paulforrester/diy-ha-sensor/README.md

# diy-ha-sensor

A DIY, USB-C powered room sensor for Home Assistant, running ESPHome. It reports:

- **presence**, including a person sitting still;
- **illuminance**, with 0.1 lx resolution near darkness;
- **temperature and humidity**, kept away from the electronics' own heat;
- **diagnostics**: Wi-Fi signal, uptime, chip temperature and sensor faults.

It is meant to be cheaper than buying several commercial sensors, and to fix what the current ones get wrong. The Apollo
MSR-2 reads several degrees high and has no humidity. The Aqara FP300 reports slowly and misses people sitting still.

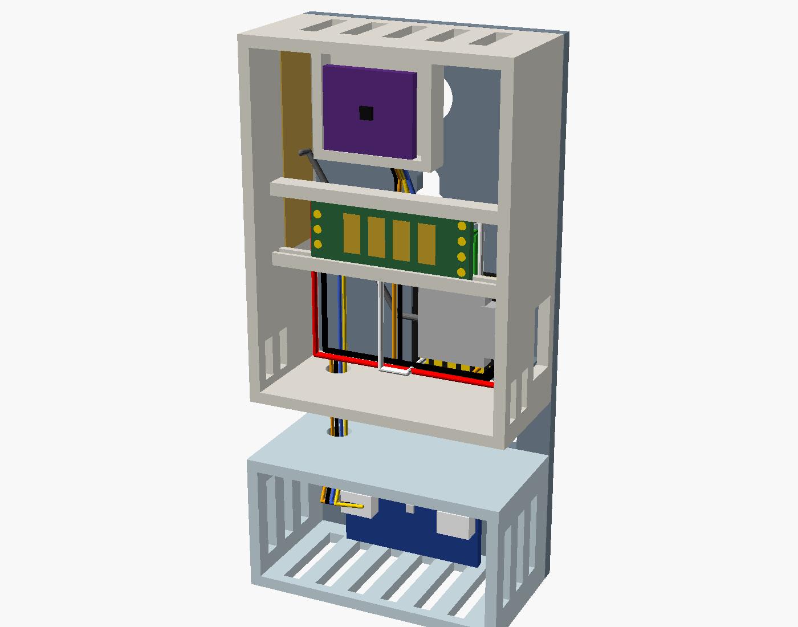
[picture p1: docs/images/concept/concept_cutaway.png]
Concept: front walls removed, showing the radar, light cell, XIAO and the separate climate pod


*Phase 0 concept render: a picture of the proposal, not a printable design (see `cad/concept/README.md`).*

## Status

**Phase 2: firmware.** The design is approved (option B) and the parts list for a run of 10 is merged. The ESPHome
firmware and CI are in review. Nothing is built yet.

- [`docs/design_proposal.md`](docs/design_proposal.md): the approved design, its reasoning and risks.
- [`docs/bom.md`](docs/bom.md): parts, quantities, sources and costs (prices live-checked 2026-10-15).
- [`firmware/README.md`](firmware/README.md): the ESPHome packages, pin map, entities and how to flash.
- [`docs/design_decisions.md`](docs/design_decisions.md): the decision log.
- Concept renders, STLs you can rotate on GitHub, and the wiring diagram are in proposal section 6.0 and
  `cad/concept/`. The real enclosure comes in Phase 3.

| Phase | Content | State |
|---|---|---|
| 0 | Questions and design proposal | Done (PR #1) |
| 1 | Bill of materials and sourcing | Done (PR #2); live prices in PR #4 |
| 2 | ESPHome firmware and CI | In review |
| 3 | OpenSCAD enclosure, fit-test coupons first | Not started |
| 4 | Build, calibration, validation and HA docs | Not started |
| 5 | Bring-up and revision from bench results | Not started |

## Repository layout

| Path | Contents |
|---|---|
| `docs/` | Design proposal and images, decision log, BOM; later the build guide, wiring, calibration, validation and HA integration |
| `tools/` | Helper scripts (BOM tables from `docs/bom.csv`) |
| `CLAUDE.md` | Context and working rules for Claude sessions on this repo |
| `firmware/` | ESPHome packages, variants and device files |
| `.github/workflows/` | CI: ESPHome config and compile, BOM table check |
| `cad/concept/` | Phase 0 concept model: OpenSCAD source, render and interference-check scripts, STLs |
| `cad/` | (Phase 3) OpenSCAD sources, STLs and renders for the real enclosure |

Secrets never go in the repo: `secrets.yaml` is git-ignored, and a `secrets.example.yaml` will show the keys needed.
