paulforrester/diy-ha-sensor/docs/bom.md

# Bill of materials and sourcing (Phase 1)

- **Date:** 2026-10-15 (`TZ=Europe/Paris date`).
- **Status:** draft for Paul's review. **Nothing is ordered**; Paul buys everything.
- **Prices:** **live-checked on 2026-10-15** for lines 1-14, from the shop pages themselves (a session on Paul's Mac,
  not behind the cloud proxy). Prices include VAT; stock, shipping and delivery estimates are in `docs/bom.csv`.
  Line 15 (PETG) is Paul's stock and isn't priced. Shop prices and stock change daily, and the cart is the only exact
  figure for delivery, VAT and duty (section 8, step 7).
- **Source of truth:** `docs/bom.csv`. The parts table and the cost tables below are generated from it by
  `python3 tools/bom_totals.py`. Edit the CSV, then re-run the script; don't edit those tables by hand.

## 1. Summary

**The run:** 10 identical standard units, plus spares. Each unit has:

- the option B design approved on PR #1:
  - XIAO ESP32-C3;
  - LD2412 radar;
  - genuine SHT45;
  - OPT3001 lux sensor;
  - the two-part case with the separate climate pod;
- a CO2 sensor as standard, so every unit is interchangeable (Paul's decision);
- a 1-Wire socket for optional remote temperature probes (DS18B20), so probes can be added later without changing
  the unit (Paul's decision; section 5);
- its own USB wall adapter and a white 2 m USB-A to USB-C cable.

**Cost** (live prices, 2026-10-15; section 4 has the detail):

| | Cost |
|---|---|
| Standard unit, per unit | about €76-86 |
| ...of which the CO2 sensor (genuine Adafruit SCD-40) | about €47-53 |
| USB adapter and cable, per unit | about €14-16.50 |
| **Whole run**, before delivery and duty | **about €1,020-1,200** |

Against the snippet estimate (€868-1,125), the low end rose by about €150 and the high end by about €70 [calc]:

- **USB adapters, about +€75:** the €2.50 adapter in the draft is an unbranded 1 A part that fails this BOM's own
  "reputable brand" rule. Branded ones on Amazon.fr cost €10-12 each (line 11). Paul decides; see section 3.
- **OPT3001 boards, about +€28, and radars, about +€21:** real listings cost more than the snippets suggested.
- **Everything from DigiKey** is within a few cents of the snippet figures.

**Why the CO2 sensor costs more than the brief's estimate.** The brief estimated €20-25 per CO2 sensor.

- That price only exists for unbranded marketplace SCD40 boards, which carry a real counterfeit and refurbished risk.
- Apollo's €23.99 SCD40 module doesn't fit this design. It plugs into a proprietary mezzanine connector on Apollo's
  board (Apollo docs, "Adding CO2 to MSR-2").

If the cost matters, the one large saving left is unbranded SCD40 boards, at about €10-25 each [S]. They would be
checked on arrival using the variant and serial commands and an outdoor reading near 420 ppm. I don't recommend it for
a run whose point is accurate, interchangeable units.

## 2. What changed since the proposal

- **Quantities:** a run of 10, not 4. Some units may go to the US; only the USB wall adapter differs (section 6).
- **CO2 is standard on every unit** (Paul, 2026-10-15).
  - The proposal's cheapest genuine option, the Apollo module, is out (connector, above), so the Adafruit SCD-40 is
    the primary.
  - Adafruit's board has a 3.3 V regulator and level shifters, and runs from 3.3 to 5 V (Adafruit-SCD-4x-PCB README
    on GitHub).
  - It is wired to the XIAO's 3V3 by default. The I2C pull-ups follow the board's supply, so feeding it 5 V could put
    5 V on the ESP32's I2C pins.
  - Phase 2 checks Adafruit's schematic, and checks the XIAO's 3.3 V regulator headroom. The XIAO wiki states both
    500 mA and 700 mA [G]. The ESP32-C3 Wi-Fi peak (350 mA) plus the SCD40 peak (175 mA) is about 525 mA [D] [A].
- **No separate cellar design.** The cellar gets a standard unit like every other room.
- **1-Wire socket on every unit** (Paul, 2026-10-15). It costs well under €1 per unit [A], and it keeps the units
  interchangeable while leaving room for remote temperature probes later (section 5).
- **USB supply and cable:** one each per unit (Paul's answer). A USB-A supply with an A-to-C cable avoids USB-C power
  negotiation questions entirely.

## 3. Parts, quantities and sources

The run quantity is the per-unit quantity × 10, plus spares.

<!-- parts:start (generated by tools/bom_totals.py) -->

| # | Part | Per unit | Run qty | Primary source | Alternative | Price each | Price basis | Counterfeit risk |
|---|---|---|---|---|---|---|---|---|
| 1 | **Seeed XIAO ESP32-C3**<br>Seeed SKU 113991054; includes the U.FL FPC antenna | 1 | 12 | [DigiKey.fr](https://www.digikey.fr/en/products/detail/seeed-technology-co-ltd/113991054/16652880) | [Gotronic](https://www.gotronic.fr/art-carte-xiao-esp32c3-35643.htm) | €5.53 - €5.90 | live-checked 2026-10-15 | low (Seeed via distributor) |
| 2 | **HLK-LD2412 radar**<br>Hi-Link LD2412, ±75° version; check firmware is not V1.26 on arrival | 1 | 12 | [AliExpress, Shenzhen Hi-Link module Store (store 4418003)](https://fr.aliexpress.com/item/1005007588627535.html) | [Domadoo (Apollo-sold module)](https://www.domadoo.fr/en/smart-home-products/8382-apollo-automation-mmwave-ld2412-sensor.html) | €4.49 - €5.99 | live-checked 2026-10-15 | low to medium (Hi-Link-named stores; which one is Hi-Link's own is not confirmed) |
| 3 | **HLK-LD2410C radar (fallback and comparison)**<br>Hi-Link LD2410C; same family as the Apollo's LD2410B | 0 | 2 | [AliExpress, Shenzhen Hi-Link Power& Radar& Router Module Store (store 1103670545)](https://fr.aliexpress.com/item/1005007273671377.html) | [Amazon.fr (RUANI 5-pack)](https://www.amazon.fr/RUANI-HLK-LD2410C-Pr%C3%A9sence-D%C3%A9tection-Mouvement/dp/B0DCJLRLKJ) | €3.59 - €5.72 | live-checked 2026-10-15 | low to medium |
| 4 | **Adafruit SHT45 breakout**<br>Adafruit product 5665 (Sensirion SHT45-AD1B, STEMMA QT) | 1 | 11 | [DigiKey.fr](https://www.digikey.fr/en/products/detail/adafruit-industries-llc/5665/17831054) | [Berrybase](https://www.berrybase.de/en/adafruit-sensirion-sht45-precision-temperature-humidity-sensor) | €13.18 - €14.90 | live-checked 2026-10-15 | low (Adafruit via distributor) |
| 5 | **OPT3001 breakout (CJMCU-3001)**<br>Generic CJMCU-3001 board: 6 pins VCC, GND, SCL, SDA, INT, ADD; no LED | 1 | 13 | [AliExpress, SZ Discount Store (CJMCU-3001)](https://fr.aliexpress.com/item/1005007837370286.html) | [AliExpress, A+A+A Store (same CJMCU-3001 layout)](https://fr.aliexpress.com/item/1005006398173401.html) | €3.19 - €3.69 | live-checked 2026-10-15 | medium (generic board; check the TI marking) |
| 6 | **JST-SH 4-pin cable for the SHT45**<br>STEMMA QT / Qwiic JST-SH plug at one end, female sockets (4397) or male pins (4209) at the other; 150 mm | 1 | 12 | [DigiKey.fr, Adafruit 4397 (female sockets)](https://www.digikey.fr/en/products/detail/adafruit-industries-llc/4397/10824270) | [DigiKey.fr, Adafruit 4209 (male header pins)](https://www.digikey.fr/en/products/detail/adafruit-industries-llc/4209/10230003) | €1.00 | live-checked 2026-10-15 | low |
| 7 | **Adafruit SCD-40 CO2 breakout**<br>Adafruit product 5187 (Sensirion SCD40, STEMMA QT, onboard 3.3 V regulator and level shifters) | 1 | 11 | [DigiKey.fr](https://www.digikey.fr/en/products/detail/adafruit-industries-llc/5187/15194668) | [Berrybase (Adafruit SCD-41, product 5190)](https://www.berrybase.de/en/adafruit-scd-41-co2-sensor-400-5000-ppm-40ppm-5-temperature-and-humidity-sensor-3.3-5v) | €47.36 - €52.90 | live-checked 2026-10-15 | low (Adafruit via distributor); high for unbranded marketplace SCD4x |
| 8 | **JST-SH 4-pin cable for the SCD-40**<br>as line 6, 150 mm | 1 | 11 | [DigiKey.fr, Adafruit 4397 (as line 6)](https://www.digikey.fr/en/products/detail/adafruit-industries-llc/4397/10824270) | [DigiKey.fr, Adafruit 4209 (as line 6)](https://www.digikey.fr/en/products/detail/adafruit-industries-llc/4209/10230003) | €1.00 | live-checked 2026-10-15 | low |
| 9 | **4.7 kΩ resistor, 1-Wire pull-up**<br>1/4 W through-hole; pulls the 1-Wire line (D2 / GPIO4) up to 3V3 | 1 | 15 | [DigiKey.fr, Stackpole CF14JT4K70](https://www.digikey.fr/en/products/detail/stackpole-electronics-inc/CF14JT4K70/1741428) | [AliExpress resistor assortment](https://www.aliexpress.com/w/wholesale-resistor-kit-1-4w.html) | €0.03 | live-checked 2026-10-15 | low |
| 10 | **JST-XH 3-pin header, 1-Wire socket**<br>JST XH series, 3 positions, 2.50 mm pitch, vertical through-hole header; mates with an XH 3-pin housing on a future probe cable | 1 | 12 | [DigiKey.fr, JST B3B-XH-A (455-2248-ND)](https://www.digikey.fr/en/products/detail/jst-sales-america-inc/B3B-XH-A/1651046) | [AliExpress, 230-piece 'XH2.54' 2-5 pin kit](https://fr.aliexpress.com/item/1005009454589816.html) | €0.12 | live-checked 2026-10-15 | low (genuine JST via distributor) |
| 11 | **USB wall adapter, 5 V**<br>USB-A output, 5 V at least 1 A (2 A preferred), EU plug, CE marked, reputable brand | 1 | 10 | [Amazon.fr, Belkin WCB002VFWH (2 × USB-A, 12 W per port)](https://www.amazon.fr/dp/B086H34XZW) | [Amazon.fr, Hama 2 × USB-A 12 W (black)](https://www.amazon.fr/dp/B0F8KHS5H9) | €9.99 - €11.99 | live-checked 2026-10-15 | medium (electrical safety: avoid unbranded adapters) |
| 12 | **USB-A to USB-C cable**<br>White, 2 m, USB-A to USB-C (Paul, 2026-10-15) | 1 | 10 | [Amazon.fr, PremiumCord USB-A to USB-C, white, 2 m](https://www.amazon.fr/dp/B08LH76K5K) | [Amazon.fr, 2-pack white 2 m USB-A to USB-C (brand SRLWMYI)](https://www.amazon.fr/dp/B0GSZGJLCF) | €3.99 - €4.50 | live-checked 2026-10-15 | low |
| 13 | **Wiring consumables**<br>26 AWG silicone hookup wire (6 colours), heat-shrink assortment, 2 × 8 cm double-sided perfboard, 2.54 mm male and female header strips | — | 1 | [AliExpress (four listings, see notes)](https://fr.aliexpress.com/item/1005010394567962.html) | Amazon.fr (not checked) | €10.46 - €26.97 | live-checked 2026-10-15 | low |
| 14 | **Fixings**<br>M2 self-tapping screws for board standoffs (assortment); wall screws and plugs (2 per unit) not priced | — | 1 | [Amazon.fr, VooGenzek 800-piece M2 self-tapping assortment](https://www.amazon.fr/dp/B09NDMWBC2) | local hardware shop | €9.99 | live-checked 2026-10-15 | low |
| 15 | **PETG filament**<br>About 60 g per unit plus fit coupons: about 0.7 kg; plus a little natural PETG only if the printed lux window is chosen | — | 1 | Paul's stock |  | €0.00 - €22.00 | assumed: Paul's stock, not priced | low |

<!-- parts:end -->

Notes per line are in `docs/bom.csv` (column `notes`); stock and delivery are in columns `stock` and `delivery`. The
ones that matter before ordering:

- **Line 1, XIAO:** buy single boards. DigiKey's 3-pack (102010572) works out at €4.74 per board but is listed
  without the U.FL antenna, which this board needs.
- **Line 2, LD2412:**
  - Pick the "HLK-LD2412 Module" variant; the listing opens on the LD2410B.
  - Three AliExpress stores carry the Hi-Link name, and Hi-Link's own site links none of them, so "Hi-Link's
    official store" is not confirmed.
  - The cheapest offer delivered is store 211069 at €4.49 each for 12, but it ships separately at €13.23. The primary
    (€4.89) ships free with the rest of order B.
  - Domadoo has only 6 in stock.
  - Check the firmware version in the ESPHome log on arrival: V1.26 has broken configuration commands
    (esphome #13366).
- **Line 4, SHT45:** the 18-week lead time in the snippet is gone: DigiKey has 1,345 in stock. Berrybase is out of
  stock.
- **Lines 4 and 7, LEDs on the Adafruit boards:** both have a green power LED (Adafruit's design files).
  - SHT45: the LED is hardwired. Desolder it.
  - SCD-40: cut solder jumper SJ3.

  Either way, no LED shows through the case vents at night.
- **Line 5, OPT3001:** a CJMCU-3001 board.
  - Both listings' photos show the ADD pin broken out and no LED.
  - ADD has a 10 kΩ resistor on the board whose direction (pull-up or pull-down) isn't visible. Measure it on arrival
    and strap ADD to VCC for 0x45 either way [A].
  - Board size isn't stated: measure it before the Phase 3 CAD.
  - The MikroElektronika Ambient 2 Click is dropped: DigiKey has none in stock, and it costs €17.92 incl. VAT.
- **Lines 6 and 8, STEMMA QT cables:** Adafruit 4397 (female sockets) or 4209 (male pins), both 150 mm and €1.00.
  Pick the end when the Phase 2 wiring is fixed.
- **Line 7, SCD-40:** DigiKey has 62 in stock, enough for 11.
- **Line 10, JST-XH header:** the part number is confirmed as **JST B3B-XH-A** (DigiKey 455-2248-ND). It moved to the
  DigiKey order (A): genuine JST, €0.12 each.
- **Line 11, USB adapter (Paul decides):** the draft's €2.50 adapter is unbranded ("Générique") and 1 A, which fails
  this line's own spec.
  - The primary is now Belkin WCB002VFWH at €11.99, sold by Amazon.
  - Hama's €9.99 adapter has only 3 in stock.
  - If Paul accepts unbranded adapters, the saving is about €75-95 for the run [calc].
- **Line 12, USB cable:** PremiumCord white 2 m at €3.99, shipped by a marketplace seller.

## 4. Cost

Prices are EUR per item including VAT. Ranges span the sources found and any assumption.

<!-- totals:start (generated by tools/bom_totals.py) -->

**Per unit** (one set of parts, no spares, no delivery):

| Build | Cost per unit | Price basis (lines) |
|---|---|---|
| Standard unit (option B with CO2) | €75.90 - €85.53 | 10 live |
| Standard unit + USB supply and cable | €89.88 - €102 | + 2 live |

**Whole run** (10 units plus spares and consumables):

| Group | Total | Price basis (lines) |
|---|---|---|
| Standard unit: option B with CO2 (MCU, radar, T/RH, lux, CO2, cables) | €860 - €973 | 10 live |
| USB supply and cable | €140 - €165 | 2 live |
| Consumables (one lot for the run) | €20.45 - €58.96 | 2 live, 1 assumed |
| **Total, before delivery and duty** | **€1,020 - €1,197** | |

**By order:**

| Order | Total |
|---|---|
| A: distributor (DigiKey.fr or Mouser.fr) | €757 - €841 |
| B: AliExpress | €113 - €158 |
| C: Amazon.fr | €150 - €175 |
| From Paul's stock | €0.00 - €22.00 |

<!-- totals:end -->

Not included above:

- **Delivery** (shop pages, 2026-10-15):
  - DigiKey.fr: free on EUR orders to France from €75, otherwise €25. Most packages arrive in 3 days. Order A is
    about €760, so it ships free.
  - AliExpress: the AliExpress-delivered listings chosen here ship free from €10, with delivery estimates of
    20-25 October. Seller-shipped listings charge per item (for example €13.23 for 12 radars from store 211069).
  - Amazon.fr: Standard delivery (3-5 working days) is free for Prime members; for others the fee is shown at
    checkout. The product pages only offered free delivery on a first order.
- **EU customs duty:** AliExpress pages say prices include VAT and duty is calculated at checkout. News reports say a
  flat €3 per goods category on parcels under €150 from outside the EU, since 2026-07-01, plus a handling fee from
  2026-11-01 whose amount isn't set [S, unverified]. With the primary listings, order B is about €118-134 [calc],
  under €150. Expect about €6-12 of duty.
- **VAT:** DigiKey lists prices ex-VAT and shows the with-VAT price on each product page; the figures here are the
  with-VAT ones. DigiKey's Incoterms page says UPS and FedEx shipments to France may be DDP (duties paid by DigiKey),
  while DHL is CPT (duty and VAT due on delivery). Pick UPS or FedEx and check the cart.
- **Berrybase** shows prices with German VAT (19 %). French VAT (20 %) may apply at checkout [A].

## 5. The 1-Wire socket and future probes

Every unit gets a socket for DS18B20 temperature probes on a cable. These are for readings away from the unit: wine or
bottle temperature in the cellar, floor versus ceiling, several racks. No probes are bought now.

- **On the unit:**
  - XIAO **D2 / GPIO4**, a free pin that is not a strapping pin (ESPHome's C3 strapping pins are GPIO2, 8 and 9);
  - a **4.7 kΩ pull-up to 3V3**;
  - a **JST-XH 3-pin header** inside the main body;
  - a cable knock-out in the case (Phase 3).
- **Firmware:** an optional ESPHome package (`one_wire` with the `gpio` platform, plus `dallas_temp`; both in
  2026.9.1), off by default (Phase 2).
- **Adding a probe later:**
  - Buy **genuine DS18B20+ chips from an authorised distributor** (DigiKey, Mouser, Farnell, RS) and build the probe:
    3-core cable, adhesive-lined heat shrink, optionally a stainless sleeve, and a pre-crimped XH 3-pin pigtail.
    Marketplace probes are not an option: a 2019 study bought DS18B20s from over 70 vendors, and every probe from eBay
    and AliExpress contained a counterfeit chip (github.com/cpetrich/counterfeit_DS18B20).
  - On first boot, check each probe's ROM code in the ESPHome log against the genuine pattern `28-xx-xx-xx-xx-00-00-xx`
    from the same study.
- **Open for bring-up:** how long a cable the 4.7 kΩ pull-up handles reliably is not established here. It is checked
  when the first probe is added [A].

## 6. Units that go to the US

- Use a US-plug 5 V USB-A adapter, bought in the US; everything else is the same.
- Those units need their own Wi-Fi credentials and DNS names; the firmware's substitutions handle that (Phase 2).

## 7. Shopping list by order

| Order | What | Qty | Why this shop |
|---|---|---|---|
| **A: DigiKey.fr** | XIAO ESP32-C3, single boards (line 1) | 12 | Genuine parts from authorised distributors, one shipment, free delivery from €75 (order is about €760) |
| | Adafruit SHT45 (4) | 11 | |
| | Adafruit SCD-40 (7) | 11 | |
| | Adafruit 4397 or 4209 STEMMA QT cables (6, 8) | 23 | |
| | Stackpole CF14JT4K70 4.7 kΩ resistors (9) | 15 | |
| | JST B3B-XH-A headers (10) | 12 | Moved from order B: genuine JST |
| **B: AliExpress** (one order) | LD2412, "HLK-LD2412 Module" variant (2) | 12 | Hi-Link-named store; AliExpress delivery, free from €10 |
| | LD2410C (3) | 2 | Hi-Link-named store |
| | CJMCU-3001 OPT3001 boards (5) | 13 | ADD pin, no LED in the photos |
| | Wiring consumables (13) | 1 lot | |
| **C: Amazon.fr** | USB wall adapters, EU plug (11) | 10 | Belkin, sold by Amazon (or Paul's choice, section 3) |
| | PremiumCord USB-A to C cables, white, 2 m (12) | 10 | |
| | M2 screw assortment (14) | 1 | |
| **Stock** | PETG filament (15) | about 0.7 kg | Colour still open |

Notes on the shopping list:

- **Order B:** one order keeps the €3 duty per goods category to a single parcel. The listings chosen are delivered
  by AliExpress and ship free from €10 (pages checked 2026-10-15). Seller-shipped listings charge shipping per item;
  check it in the cart.
- **EU fallback for the radars:** if the AliExpress lead time is a problem, Domadoo has the LD2412 at €5.99, but only
  6 in stock on 2026-10-15. OpenELAB and SmartHomeShop were not checked.

## 8. Live price pass

**Done on 2026-10-15** for lines 1-14 by a Claude Code session on Paul's Mac (branch `bom-live-prices`). Every shop
page opened:

- DigiKey.fr, Gotronic, Berrybase and Domadoo;
- AliExpress (fr.aliexpress.com, prices in EUR, shipping to France);
- Amazon.fr (delivering to Bordeaux, not signed in).

The draft's gaps are filled: the OPT3001 board, the JST-SH cables, the JST-XH part number, the white 2 m cables and
the SCD-40's DigiKey URL. Section 3 has the results. Stock and marketplace prices move, so repeat the pass with these
steps if the order is placed more than a few days later:

1. **Check out the branch.** Work on this PR's branch, and check that the PR isn't merged yet.
2. **Price each line.** For each line in `docs/bom.csv`, open the primary and alternative product pages. Record in
   that row:
   - the price including VAT, delivered to France;
   - the exact product URL;
   - stock;
   - shipping cost or free-delivery threshold;
   - delivery estimate.
3. **Label the prices.**
   - Set `price_status` to `live-checked YYYY-MM-DD`, and `date_checked` to the date.
   - Keep `eur_low` / `eur_high` as the cheapest and dearest credible offers.
   - If a page can't be read (JavaScript-only or bot-blocked pages are common on AliExpress, Amazon, DigiKey and
     Mouser), leave the line `estimated` and say so in `notes`. Never record a guess as live.
4. **Check the choices still hold.** On AliExpress, select the right variant before reading the price (the listings
   open on a different model). Raise the quantity to the run quantity to see seller shipping, which scales with
   quantity.
5. **Regenerate.** Re-run `python3 tools/bom_totals.py` and check that the tables in sections 3 and 4 changed as
   expected.
6. **Commit.** Commit with a message that lists which lines were live-checked, and push to the same branch.
7. **Final check by Paul.** The cart is the only exact figure for delivery, VAT and duty, so Paul checks it before
   paying.

## 9. Open questions

The BOM itself has no open questions left. These are still open from the proposal (section 10 there), and none of
them blocks ordering:

- rooms and mounting positions;
- filament colour;
- Bluetooth proxy;
- the device naming pattern (`sense-<room>` suggested);
- whether `mulet.flypig.net` may appear in the public repo;
- the Arty Player and Apollo settings.

## 10. Sources

- **Prices, URLs, stock and shipping:** the shop pages themselves, read on 2026-10-15 (section 8). Shipping rules:
  DigiKey.fr "Delivery Time and Cost" and "Incoterms" help pages; Gotronic product page (Livraison tab); Berrybase
  "Payment / Dispatch"; Domadoo "Delivery"; Amazon.fr "Delivery Costs and Times in Mainland France and Monaco". The
  notes behind each figure are in the `notes` column of `docs/bom.csv`.
- **Apollo SCD40 module connector:** Apollo docs, `docs/products/msr2/addons/adding-co2-to-msr-2.md` in
  https://github.com/ApolloAutomation/docs.
- **Adafruit SCD-4x board** (regulator and level shifters): https://github.com/adafruit/Adafruit-SCD-4x-PCB README.
- **Adafruit SHT4x boards:** https://github.com/adafruit/Adafruit-SHT40-PCB README (products 4885, 5776, 5665).
- **DS18B20 counterfeits and the ROM-pattern check:** https://github.com/cpetrich/counterfeit_DS18B20 README.
- **ESPHome 2026.9.1:** `one_wire`, `gpio` 1-Wire platform, `dallas_temp`, and the ESP32-C3 strapping pins
  (`esp32/gpio_esp32_c3.py`), checked in the installed source.
- **XIAO ESP32-C3 regulator rating** (500 mA and 700 mA both stated): Seeed wiki source on GitHub, as cited in
  `docs/design_proposal.md` section 11.
