paulforrester/diy-ha-sensor/docs/bom.csv

id | group | part | spec | qty_per_unit | units | spares | qty_total | primary_source | primary_url | primary_eur | alt_source | alt_url | alt_eur | eur_low | eur_high | price_status | date_checked | shipping_to_fr | delivery | stock | counterfeit_risk | order | notes
1 | core | Seeed XIAO ESP32-C3 | Seeed SKU 113991054; includes the U.FL FPC antenna | 1 | 10 | 2 | 12 | DigiKey.fr | https://www.digikey.fr/en/products/detail/seeed-technology-co-ltd/113991054/16652880 | 5.53 | Gotronic | https://www.gotronic.fr/art-carte-xiao-esp32c3-35643.htm | 5.90 | 5.53 | 5.90 | live-checked 2026-10-15 | 2026-10-15 | DigiKey.fr: free from €75 (EUR orders to France), else €25. Gotronic: Lettre suivie €2.90 (free from €30), relay from €4.50 (free from €120), Colissimo €5.90 (free from €180) | DigiKey: most packages to France in 3 days (DigiKey delivery page); standard lead time 4 weeks. Gotronic: 48 h by relay or Colissimo, about 4 days by Lettre suivie | DigiKey 9,349; Gotronic 210 | low (Seeed via distributor) | A | DigiKey €4.61 ex-VAT, €5.53 with VAT; includes the U.FL antenna (DigiKey attribute). The 3-pack 102010572 (€14.21 incl. VAT, €4.74 per board) is listed as 'U.FL Antenna(s) Not Included', so it is not cheaper once antennas are added. Gotronic €5.90 TTC (€4.92 HT, includes €0.05 eco-part).
2 | core | HLK-LD2412 radar | Hi-Link LD2412, ±75° version; check firmware is not V1.26 on arrival | 1 | 10 | 2 | 12 | AliExpress, Shenzhen Hi-Link module Store (store 4418003) | https://fr.aliexpress.com/item/1005007588627535.html | 4.89 | Domadoo (Apollo-sold module) | https://www.domadoo.fr/en/smart-home-products/8382-apollo-automation-mmwave-ld2412-sensor.html | 5.99 | 4.49 | 5.99 | live-checked 2026-10-15 | 2026-10-15 | AliExpress-delivered listing: free from €10 (Colissimo, Colis Privé, Mondial Relay). Domadoo: Mondial Relay €3.90 below €139, free from €139; DPD Pickup €4.90 below €149 | AliExpress primary: 20-24 Oct. Domadoo: same-day dispatch if paid before 10:00 | AliExpress primary 45; Domadoo 6 (fewer than the 12 needed) | low to medium (Hi-Link-named stores; which one is Hi-Link's own is not confirmed) | B | Pick the 'HLK-LD2412 Module' variant (€4.89; the listing's default is LD2410B). Prices include VAT; AliExpress says duty is calculated at checkout. Low end: 'Shenzhen Hi-Link IoT Module Store' (store 211069), https://fr.aliexpress.com/item/1005006990598837.html, €3.39 each + €13.23 seller shipping for 12 = €4.49 each delivered, 97 in stock, 23-29 Oct. Three AliExpress stores use the Hi-Link name (4418003, 211069, 1103670545); hlktech.net's home page links none of them, so which one is Hi-Link's own is not confirmed. Store 1103670545: LD2412 €5.09 (21 in stock) on item 1005007989577185, and 'cannot be delivered to this address' on item 1005007273671377. The primary listing's photo says a new version with a revised antenna layout keeps the same size and pinout (seller's claim). Domadoo's page text says '60 GHz'; the LD2412 is a 24 GHz radar, so treat that page's specs with care.
3 | core | HLK-LD2410C radar (fallback and comparison) | Hi-Link LD2410C; same family as the Apollo's LD2410B | 0 | 10 | 2 | 2 | AliExpress, Shenzhen Hi-Link Power& Radar& Router Module Store (store 1103670545) | https://fr.aliexpress.com/item/1005007273671377.html | 3.59 | Amazon.fr (RUANI 5-pack) | https://www.amazon.fr/RUANI-HLK-LD2410C-Pr%C3%A9sence-D%C3%A9tection-Mouvement/dp/B0DCJLRLKJ | 5.72 | 3.59 | 5.72 | live-checked 2026-10-15 | 2026-10-15 | AliExpress-delivered listing: free from €10. Amazon.fr: seller-dependent; the page offered free delivery on a first order only | AliExpress: 22-25 Oct. Amazon.fr: 17-18 Oct | AliExpress: not shown; Amazon.fr: in stock | low to medium | B | Two only: a side-by-side comparison on the first unit, and a fallback if an LD2412 has bad firmware. Pick the 'HLK-LD2410C' variant. Amazon.fr is a 5-pack at €28.59 (€5.72 each, sold by faxinhuif), so it means buying 5 for 2. Also seen: store 4418003 item 1005002765790429 at €3.29 + €3.40 seller shipping for one.
4 | core | Adafruit SHT45 breakout | Adafruit product 5665 (Sensirion SHT45-AD1B, STEMMA QT) | 1 | 10 | 1 | 11 | DigiKey.fr | https://www.digikey.fr/en/products/detail/adafruit-industries-llc/5665/17831054 | 13.18 | Berrybase | https://www.berrybase.de/en/adafruit-sensirion-sht45-precision-temperature-humidity-sensor | 14.90 | 13.18 | 14.90 | live-checked 2026-10-15 | 2026-10-15 | DigiKey.fr: free from €75 (EUR orders to France), else €25. Berrybase to EU countries: DHL €9.90, free from €250 | DigiKey: most packages to France in 3 days (DigiKey delivery page); standard lead time 4 weeks. Berrybase: not stated for France | DigiKey 1,345; Berrybase out of stock ('Currently not available') | low (Adafruit via distributor) | A | DigiKey €10.98 ex-VAT, €13.18 with VAT. The earlier 18-week lead-time snippet is out of date. Berrybase €14.90 is shown with German VAT (19 %); French VAT may apply at checkout [A]. Botland not checked. Check the laser marking, address 0x44 and the serial number on arrival (proposal 4.4). Board facts from Adafruit's design files (Adafruit-SHT40-PCB, SHT45 .brd/.sch): 25.4 x 17.78 mm, four 2.5 mm plated holes at 2.54 mm from the edges, AP2127K-3.3 regulator. Its green power LED (D1) is hardwired with no jumper: desolder it before assembly so no light leaks from the climate pod.
5 | core | OPT3001 breakout (CJMCU-3001) | Generic CJMCU-3001 board: 6 pins VCC, GND, SCL, SDA, INT, ADD; no LED | 1 | 10 | 3 | 13 | AliExpress, SZ Discount Store (CJMCU-3001) | https://fr.aliexpress.com/item/1005007837370286.html | 3.19 | AliExpress, A+A+A Store (same CJMCU-3001 layout) | https://fr.aliexpress.com/item/1005006398173401.html | 3.69 | 3.19 | 3.69 | live-checked 2026-10-15 | 2026-10-15 | AliExpress-delivered listing: free from €10 (both listings) | Primary: 22-25 Oct. Alternative: 20-24 Oct | Primary 984; alternative not shown | medium (generic board; check the TI marking) | B | Photos on both listings show the ADD pin broken out, the OPT3001, a 3-pin SOT-23 part, four resistors, two capacitors and no LED. ADD has a resistor on the board ('103', 10 kΩ, in the A+A+A photo); whether it pulls up or down is not visible, so measure it on arrival and strap ADD to VCC for 0x45 either way [A]. Board size is not stated on either listing: measure on arrival before the Phase 3 CAD. Rejected: SZFYDOSH green board (item 1005009295513152, €2.16) has no ADDR pin (solder pads 44/45/46/47 instead) and only 13 in stock; MikroElektronika Ambient 2 Click (MIKROE-1903) on DigiKey is €14.93 ex-VAT and out of stock (MIKROE-5544: 1 in stock).
6 | core | JST-SH 4-pin cable for the SHT45 | STEMMA QT / Qwiic JST-SH plug at one end, female sockets (4397) or male pins (4209) at the other; 150 mm | 1 | 10 | 2 | 12 | DigiKey.fr, Adafruit 4397 (female sockets) | https://www.digikey.fr/en/products/detail/adafruit-industries-llc/4397/10824270 | 1.00 | DigiKey.fr, Adafruit 4209 (male header pins) | https://www.digikey.fr/en/products/detail/adafruit-industries-llc/4209/10230003 | 1.00 | 1.00 | 1.00 | live-checked 2026-10-15 | 2026-10-15 | with order A | DigiKey: most packages to France in 3 days (DigiKey delivery page) | 4397: 4,325; 4209: 5,948 | low | A | Both €0.83 ex-VAT, €1.00 with VAT, 150 mm. Pick the end (female or male pins) when the Phase 2 wiring is fixed. Crosses the air gap between the body and the climate pod. AliExpress: two searches found only double-ended SH cables or loose crimped leads, no single-ended 4-pin pigtail, so no AliExpress price.
7 | core | Adafruit SCD-40 CO2 breakout | Adafruit product 5187 (Sensirion SCD40, STEMMA QT, onboard 3.3 V regulator and level shifters) | 1 | 10 | 1 | 11 | DigiKey.fr | https://www.digikey.fr/en/products/detail/adafruit-industries-llc/5187/15194668 | 47.36 | Berrybase (Adafruit SCD-41, product 5190) | https://www.berrybase.de/en/adafruit-scd-41-co2-sensor-400-5000-ppm-40ppm-5-temperature-and-humidity-sensor-3.3-5v | 52.90 | 47.36 | 52.90 | live-checked 2026-10-15 | 2026-10-15 | DigiKey.fr: free from €75 (EUR orders to France), else €25. Berrybase to EU countries: DHL €9.90, free from €250 | DigiKey: most packages to France in 3 days (DigiKey delivery page); standard lead time 4 weeks. Berrybase: '1-3 days' on the page | DigiKey 62; Berrybase 23 | low (Adafruit via distributor); high for unbranded marketplace SCD4x | A | DigiKey €39.47 ex-VAT, €47.36 with VAT. Berrybase SCD-41 €52.90 is shown with German VAT (19 %); French VAT may apply at checkout [A]. DigiKey also lists the Adafruit SCD-41 (5190) at €43.86 ex-VAT (seen in a related-products panel, not opened). Apollo's €23.99 SCD40 module is not usable here: it plugs into a proprietary mezzanine connector (Apollo docs). Other genuine options not checked: SparkFun SCD40 Qwiic (22395), Seeed Grove SCD41, DFRobot SCD41. Board facts from Adafruit's design files (Adafruit-SCD-4x-PCB, SCD-41 .brd/.sch, assumed the same PCB as the SCD-40 [A]): 25.4 x 22.86 mm, four 3.0 mm plated holes, AP2112K-3.3 regulator. Cut solder jumper SJ3 to turn off its green power LED. Powered from the XIAO 3V3, its I2C pull-ups sit at 3.3 V whatever SJ1 is set to.
8 | core | JST-SH 4-pin cable for the SCD-40 | as line 6, 150 mm | 1 | 10 | 1 | 11 | DigiKey.fr, Adafruit 4397 (as line 6) | https://www.digikey.fr/en/products/detail/adafruit-industries-llc/4397/10824270 | 1.00 | DigiKey.fr, Adafruit 4209 (as line 6) | https://www.digikey.fr/en/products/detail/adafruit-industries-llc/4209/10230003 | 1.00 | 1.00 | 1.00 | live-checked 2026-10-15 | 2026-10-15 | with order A | DigiKey: most packages to France in 3 days (DigiKey delivery page) | as line 6 | low | A | Adafruit's pigtails are 150 mm, not the 100 mm first planned; the spare length folds inside the body.
9 | core | 4.7 kΩ resistor, 1-Wire pull-up | 1/4 W through-hole; pulls the 1-Wire line (D2 / GPIO4) up to 3V3 | 1 | 10 | 5 | 15 | DigiKey.fr, Stackpole CF14JT4K70 | https://www.digikey.fr/en/products/detail/stackpole-electronics-inc/CF14JT4K70/1741428 | 0.03 | AliExpress resistor assortment | https://www.aliexpress.com/w/wholesale-resistor-kit-1-4w.html |  | 0.03 | 0.03 | live-checked 2026-10-15 | 2026-10-15 | with order A | DigiKey: most packages to France in 3 days (DigiKey delivery page) | DigiKey 255,739 | low | A | RES 4.7K OHM 5% 1/4W AXIAL, carbon film. €0.024 ex-VAT each at 10+ (€0.09 for one). Part of the 1-Wire socket on every unit (decision 2026-10-15). AliExpress assortment not checked: not worth it at this price.
10 | core | JST-XH 3-pin header, 1-Wire socket | JST XH series, 3 positions, 2.50 mm pitch, vertical through-hole header; mates with an XH 3-pin housing on a future probe cable | 1 | 10 | 2 | 12 | DigiKey.fr, JST B3B-XH-A (455-2248-ND) | https://www.digikey.fr/en/products/detail/jst-sales-america-inc/B3B-XH-A/1651046 | 0.12 | AliExpress, 230-piece 'XH2.54' 2-5 pin kit | https://fr.aliexpress.com/item/1005009454589816.html |  | 0.12 | 0.12 | live-checked 2026-10-15 | 2026-10-15 | with order A. AliExpress kit: AliExpress-delivered listing: free from €10 | DigiKey: most packages to France in 3 days (DigiKey delivery page). AliExpress kit: 20-24 Oct | DigiKey 70,172 | low (genuine JST via distributor) | A | Part number confirmed on DigiKey: B3B-XH-A is JST's XH 3-position, 2.50 mm, vertical through-hole male header. €0.097 ex-VAT each at 10+. Moved from order B to A: genuine JST, in the DigiKey order anyway. The AliExpress kit is €3.39 per kit (headers, housings and contacts; the number of 3-pin headers is not stated) and is labelled 2.54 mm, while genuine XH is 2.50 mm; fine over 3 pins, but genuine parts mate best with a genuine XH housing on a future probe. Socket only; no probes are bought now. Pin order (3V3, DATA, GND) is fixed in Phase 2 [A].
11 | power | USB wall adapter, 5 V | USB-A output, 5 V at least 1 A (2 A preferred), EU plug, CE marked, reputable brand | 1 | 10 | 0 | 10 | Amazon.fr, Belkin WCB002VFWH (2 × USB-A, 12 W per port) | https://www.amazon.fr/dp/B086H34XZW | 11.99 | Amazon.fr, Hama 2 × USB-A 12 W (black) | https://www.amazon.fr/dp/B0F8KHS5H9 | 9.99 | 9.99 | 11.99 | live-checked 2026-10-15 | 2026-10-15 | Amazon.fr: sold and shipped by Amazon (both). Standard delivery free for Prime; for others the fee is shown at checkout (Amazon.fr help page) | Belkin: fastest 16 Oct, standard 18 Oct. Hama: 21-22 Oct | Belkin in stock; Hama only 3 left | medium (electrical safety: avoid unbranded adapters) | C | Correction to the draft: its listing (B0CLMBHCVF, €4.99 for 2) is brand 'Générique', 5 V 1 A, so it fails this line's 'reputable brand' rule; dropped. Cheap branded single adapters were not found on Amazon.fr: Amazon's own 5 W adapter (B01J2G52O6) is also €11.99 and only 1 A. Hama has 3 in stock, not enough for 10. Units that go to the US need US-plug adapters; buy those in the US. Peak load is about 0.7 A at 5 V with the CO2 sensor (proposal 6.2 plus SCD40 peak).
12 | power | USB-A to USB-C cable | White, 2 m, USB-A to USB-C (Paul, 2026-10-15) | 1 | 10 | 0 | 10 | Amazon.fr, PremiumCord USB-A to USB-C, white, 2 m | https://www.amazon.fr/dp/B08LH76K5K | 3.99 | Amazon.fr, 2-pack white 2 m USB-A to USB-C (brand SRLWMYI) | https://www.amazon.fr/dp/B0GSZGJLCF | 4.50 | 3.99 | 4.50 | live-checked 2026-10-15 | 2026-10-15 | PremiumCord: shipped by the seller (EUROPETECH), fee shown at checkout. 2-pack: dispatched by Amazon | PremiumCord: 23-24 Oct. 2-pack: 18 Oct | PremiumCord in stock; 2-pack 14 left (5 packs needed) | low | C | 2-pack is €8.99, so €4.50 per cable. The listings' current and wattage claims are marketing; the unit draws about 0.7 A at peak. USB-A on the adapter end matches line 11 and avoids any USB-C power-negotiation issue. 2 m white chosen by Paul so every unit is the same.
13 | consumables | Wiring consumables | 26 AWG silicone hookup wire (6 colours), heat-shrink assortment, 2 × 8 cm double-sided perfboard, 2.54 mm male and female header strips | 1 | 1 | 0 | 1 | AliExpress (four listings, see notes) | https://fr.aliexpress.com/item/1005010394567962.html |  | Amazon.fr (not checked) |  |  | 10.46 | 26.97 | live-checked 2026-10-15 | 2026-10-15 | AliExpress-delivered listing: free from €10 (all four) | 20-25 Oct | not shown | low | B | One lot for the whole run; skip anything Paul already has. Wire: AuHo DIY Store, 26 AWG, 6 colours, €4.59 for 3 m each or €16.49 for 10 m each (item 1005010394567962). Heat-shrink: 164 pieces €1.91 or 328 pieces €3.19 (item 1005008146302901). Perfboard 2 × 8 cm double-sided: 5 for €1.82 or 10 for €3.09 (item 32888385898). Headers 1 × 40, pack of 10: male €2.14, female €2.06 (item 1005007611658076). Low = smallest packs, male headers only; high = largest packs plus female headers [calc].
14 | consumables | Fixings | M2 self-tapping screws for board standoffs (assortment); wall screws and plugs (2 per unit) not priced | 1 | 1 | 0 | 1 | Amazon.fr, VooGenzek 800-piece M2 self-tapping assortment | https://www.amazon.fr/dp/B09NDMWBC2 | 9.99 | local hardware shop |  |  | 9.99 | 9.99 | live-checked 2026-10-15 | 2026-10-15 | Amazon.fr: dispatched by Amazon; fee shown at checkout unless Prime | fastest 16 Oct, standard 18 Oct | in stock | low | C | Price covers the M2 screw assortment only (8 lengths, cylinder head). Wall screws and plugs are not priced: Paul's stock or a local hardware shop. Exact screws are decided in Phase 3.
15 | consumables | PETG filament | About 60 g per unit plus fit coupons: about 0.7 kg; plus a little natural PETG only if the printed lux window is chosen | 1 | 1 | 0 | 1 | Paul's stock |  |  |  |  |  | 0.00 | 22.00 | assumed: Paul's stock, not priced | 2026-10-15 |  |  |  | low | stock | Colour still open (proposal question 6). Not PETG-CF anywhere near the radar. Not live-checked: Paul already has the filament.
