paulforrester/diy-ha-sensor/cad/concept/stl/concept_electronics.stl

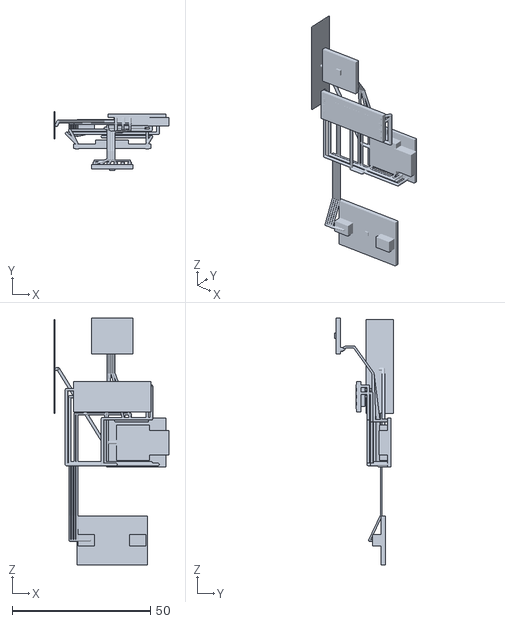
[picture p9: CAD file, 2026-10-15]
cad/concept/stl/concept_electronics.stl
41.5 x 21.5 x 89.4
