paulforrester/diy-ha-sensor/cad/concept/stl/concept_body_shell.stl

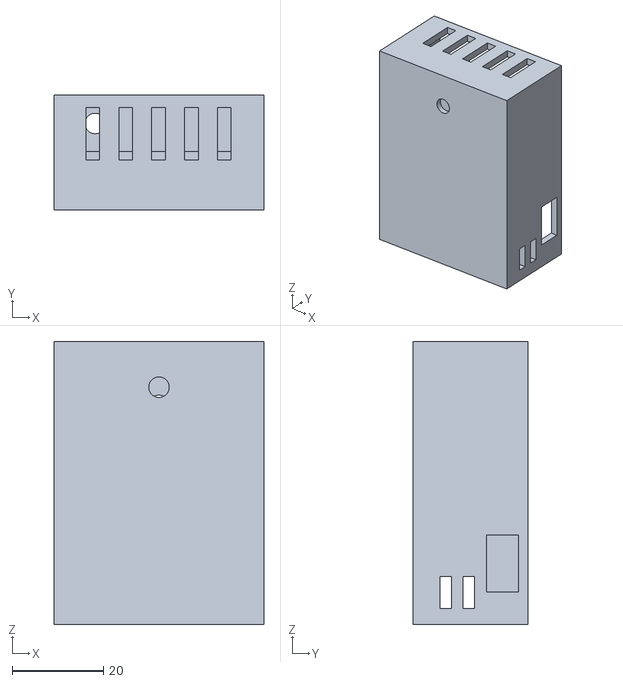
[picture p10: CAD file, 2026-10-15]
cad/concept/stl/concept_body_shell.stl
46.0 x 25.3 x 62.0
