paulforrester/diy-ha-sensor/cad/concept/stl/concept_pod_shell.stl

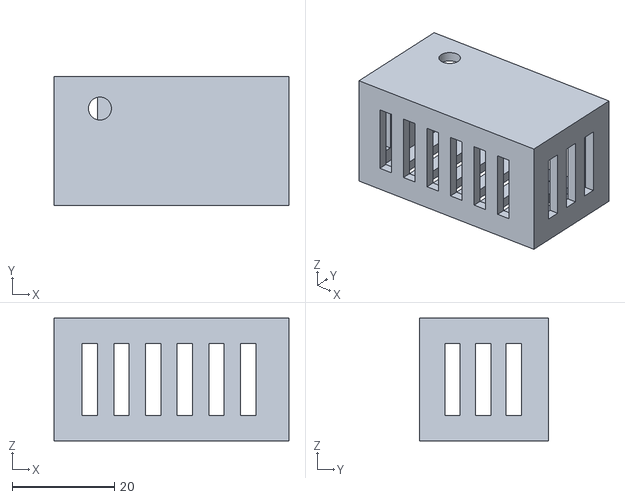
[picture p11: CAD file, 2026-10-15]
cad/concept/stl/concept_pod_shell.stl
46.0 x 25.3 x 24.0
