paulforrester/diy-ha-sensor/cad/concept/stl/concept_back_plate.stl

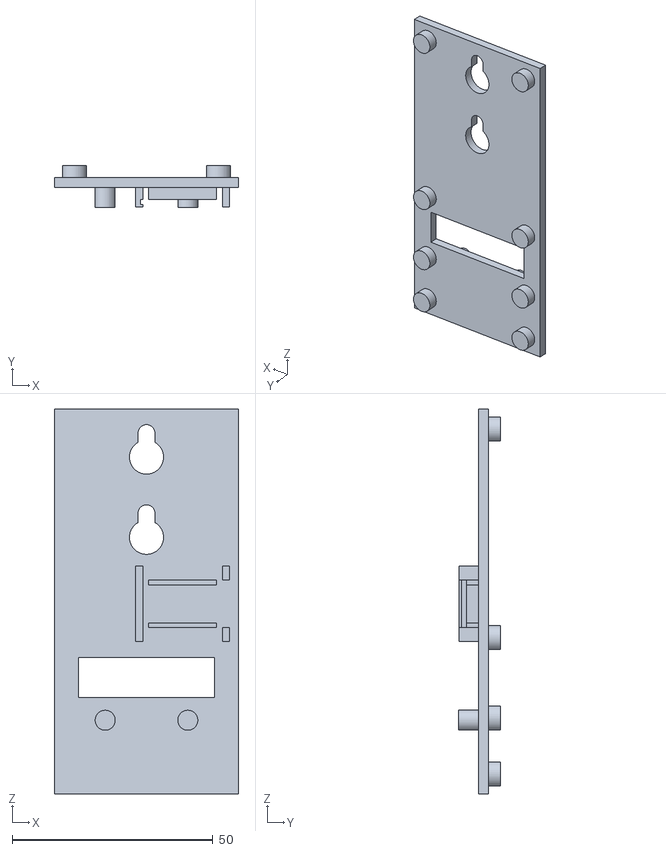
[picture p12: CAD file, 2026-10-15]
cad/concept/stl/concept_back_plate.stl
46.0 x 10.5 x 96.0
