paulforrester/diy-ha-sensor/(commit log)

2026-10-15 Add Phase 0 design proposal and README (draft)
    Options, recommendation, cost estimates, enclosure concept, risks and
    questions for Paul. Lux datasheet figures still to be confirmed.
    Claude-Session: https://claude.ai/code/session_01QFdPiRGyBJ2B7HDeDnCiZS
2026-10-15 Finish Phase 0 design proposal
    Confirm lux sensor figures from the TI, Vishay, ROHM and Lite-On
    datasheets; recommend OPT3001 behind an open aperture; add the Apollo
    calibration outline, the cellar-probe question and consistency fixes.
    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
2026-10-15 CLAUDE.md: fix section reference and I2C bus note
    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
2026-10-15 Add Phase 0 concept model, 3D renders and wiring diagram
    OpenSCAD concept of option B (not for printing): back plate, body shell
    and pod shell, with the XIAO ESP32-C3, LD2412, OPT3001 and SHT45 boards
    and all wiring. Adds PNG renders (assembly, cutaway, section,
    electronics, exploded, parts), STLs viewable on GitHub, a Graphviz pin
    map, render and CGAL interference-check scripts, a preliminary pin map
    in the proposal, and the OpenSCAD/Graphviz install notes in CLAUDE.md.
    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
    [concept.scad, concept_back_plate.stl, concept_body_shell.stl, concept_electronics.stl, concept_pod_shell.stl]
2026-10-15 Phase 1: bill of materials and sourcing for a run of 10
    Add docs/bom.md and docs/bom.csv (source of truth) for 10 option B units
    with CO2 and USB supplies, spares, and a cellar unit with genuine DS18B20
    probes. tools/bom_totals.py regenerates the parts and cost tables from
    the CSV. Start docs/design_decisions.md with Paul's Phase 0 answers and
    the proposed sourcing decisions. Prices are search-snippet estimates or
    assumptions, labelled as such; the live price pass is described in
    docs/bom.md section 8.
    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
    [bom.csv]
2026-10-15 BOM: CO2 standard on every unit; drop the cellar DS18B20 add-on
    Paul decided CO2 is standard so units are interchangeable, and there is
    no separate cellar design: the cellar gets a standard unit. Remove the
    DS18B20 lines, fold the SCD-40 into the standard unit, renumber the
    CSV, regenerate the tables, and log the decision with in-place
    corrections. Also note the XIAO 3.3 V regulator headroom check for the
    SCD-40 in Phase 2.
    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
    [bom.csv]
2026-10-15 Add a 1-Wire probe socket to every unit
    Paul decided every unit gets a 1-Wire socket so DS18B20 probes can be
    added later while units stay interchangeable: XIAO D2/GPIO4 (not a
    strapping pin), 4.7 kOhm pull-up to 3V3, JST-XH 3-pin header, a cable
    knock-out in Phase 3 and an optional firmware package in Phase 2. Add
    the two BOM lines, a future-probes section with the genuine-chip rule,
    the decision log entry, and the pin map. Also add the SCD-40 (now
    standard) and the socket to the concept wiring diagram.
    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
    [bom.csv]
2026-10-15 BOM: white 2 m USB-A to USB-C cables for every unit
    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
    [bom.csv]
2026-10-15 Phase 2: ESPHome firmware packages and CI
    ESPHome 2026.9.1 packages for the standard unit (XIAO ESP32-C3, LD2412,
    SHT45, OPT3001, SCD40, 1-Wire socket), the LD2410C fallback variant,
    optional 1-Wire probe and Bluetooth proxy packages, a bench device file,
    a secrets example and a throwaway-secrets script for CI.
    CI (.github/workflows/ci.yml) validates every config, compiles three
    targets and checks that docs/bom.md matches docs/bom.csv.
    Hardware facts checked for the firmware: the XIAO pinout against
    Seeed's official image; its 3V3 rating (700 mA); Adafruit's SCD-41
    schematic (3V3 supply keeps the I2C bus at 3.3 V); and the green power
    LEDs on both Adafruit boards. These are logged in
    docs/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
    [bom.csv]
2026-10-15 BOM: live price pass, 2026-10-15
    Live-checked lines 1-14 on the shop pages (DigiKey.fr, Gotronic, Berrybase,
    Domadoo, AliExpress, Amazon.fr): price incl. VAT, URL, stock, shipping and
    delivery estimate. Line 15 (PETG) is Paul's stock and stays unpriced.
    - Fills the gaps: CJMCU-3001 OPT3001 board (ADD pin, no LED), Adafruit
    4397/4209 STEMMA QT cables, JST B3B-XH-A confirmed (DigiKey 455-2248-ND),
    PremiumCord white 2 m USB-A to C cable, DigiKey URL for Adafruit 5187.
    - Adds a stock column to bom.csv.
    - USB adapter: the draft's EUR 2.50 one is unbranded 1 A and fails the
    line's own spec; Belkin at EUR 11.99 is the default, Paul decides.
    - JST-XH header moves to the DigiKey order.
    - Run t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
    [bom.csv]
